PasLin67/Matrix_Led_Shield/4x4_Matrix_Led_Shield Eagle file/matrix_led_schield.brd

## EAGLE design 4x4_Matrix_Led_Shield Eagle file/matrix_led_schield.brd (2018-12-17)

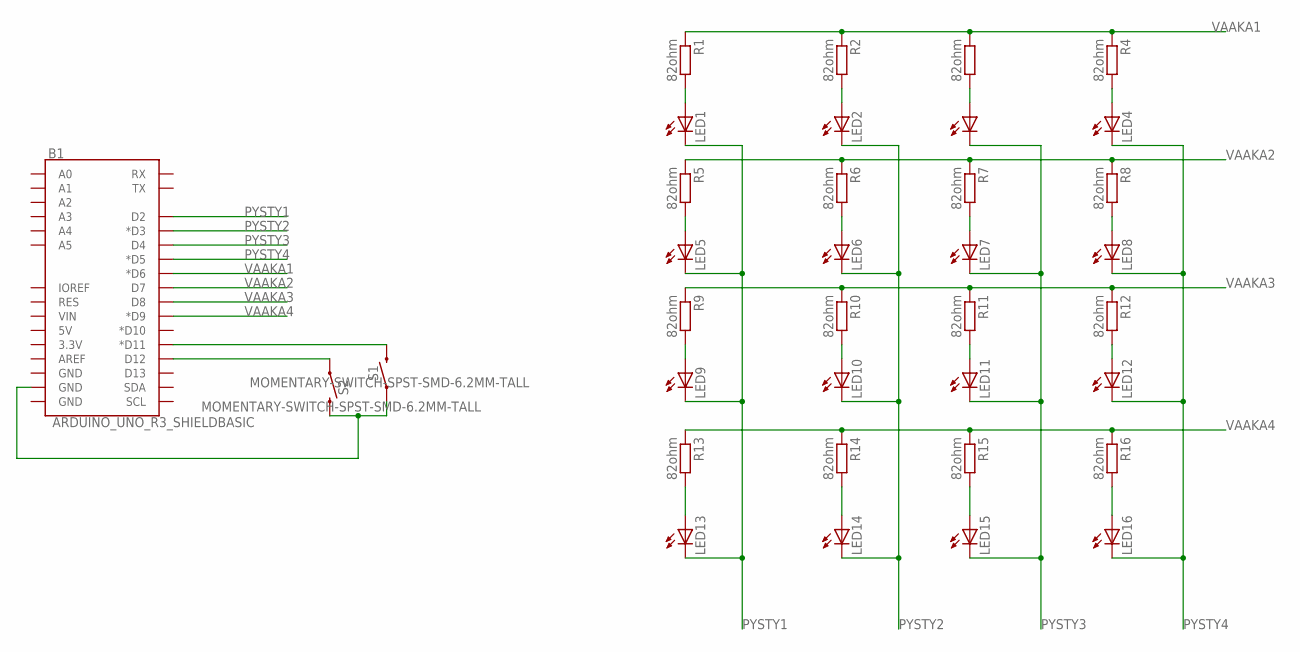
[picture p3: schematic matrix_led_shield_schematic.sch]

Parts:
B1: ARDUINO_UNO_R3_SHIELDBASIC; UNO_R3_SHIELD
LED1, LED2, LED3, LED4, LED5, LED6, LED7, LED8, LED9, LED10, LED11, LED12, LED13, LED14, LED15, LED16: LG_T679-E1F1-1; PLCC2
R1, R2, R3, R4, R5, R6, R7, R8, R9, R10, R11, R12, R13, R14, R15, R16: 82ohm; M0805
S1, S2: MOMENTARY-SWITCH-SPST-SMD-6.2MM-TALL; TACTILE_SWITCH_SMD_6.2MM_TALL

Connections:
unnamed: B1.D12, S2.A2 (1)
unnamed: B1.D11 (*D11), S1.B2 (2)
unnamed: B1.GND@1 (GND), S1.A2 (1), S2.B2 (2)
unnamed: LED1.A, R1.2
unnamed: LED2.A, R2.2
unnamed: LED3.A, R3.2
unnamed: LED4.A, R4.2
unnamed: LED5.A, R5.2
unnamed: LED6.A, R6.2
unnamed: LED7.A, R7.2
unnamed: LED8.A, R8.2
unnamed: LED9.A, R9.2
unnamed: LED10.A, R10.2
unnamed: LED11.A, R11.2
unnamed: LED12.A, R12.2
unnamed: LED13.A, R13.2
unnamed: LED14.A, R14.2
unnamed: LED15.A, R15.2
unnamed: LED16.A, R16.2
PYSTY1: B1.D2, LED1.C, LED5.C, LED9.C, LED13.C
PYSTY2: B1.D3 (*D3), LED2.C, LED6.C, LED10.C, LED14.C
PYSTY3: B1.D4, LED3.C, LED7.C, LED11.C, LED15.C
PYSTY4: B1.D5 (*D5), LED4.C, LED8.C, LED12.C, LED16.C
VAAKA1: B1.D6 (*D6), R1.1, R2.1, R3.1, R4.1
VAAKA2: B1.D7, R5.1, R6.1, R7.1, R8.1
VAAKA3: B1.D8, R9.1, R10.1, R11.1, R12.1
VAAKA4: B1.D9 (*D9), R13.1, R14.1, R15.1, R16.1

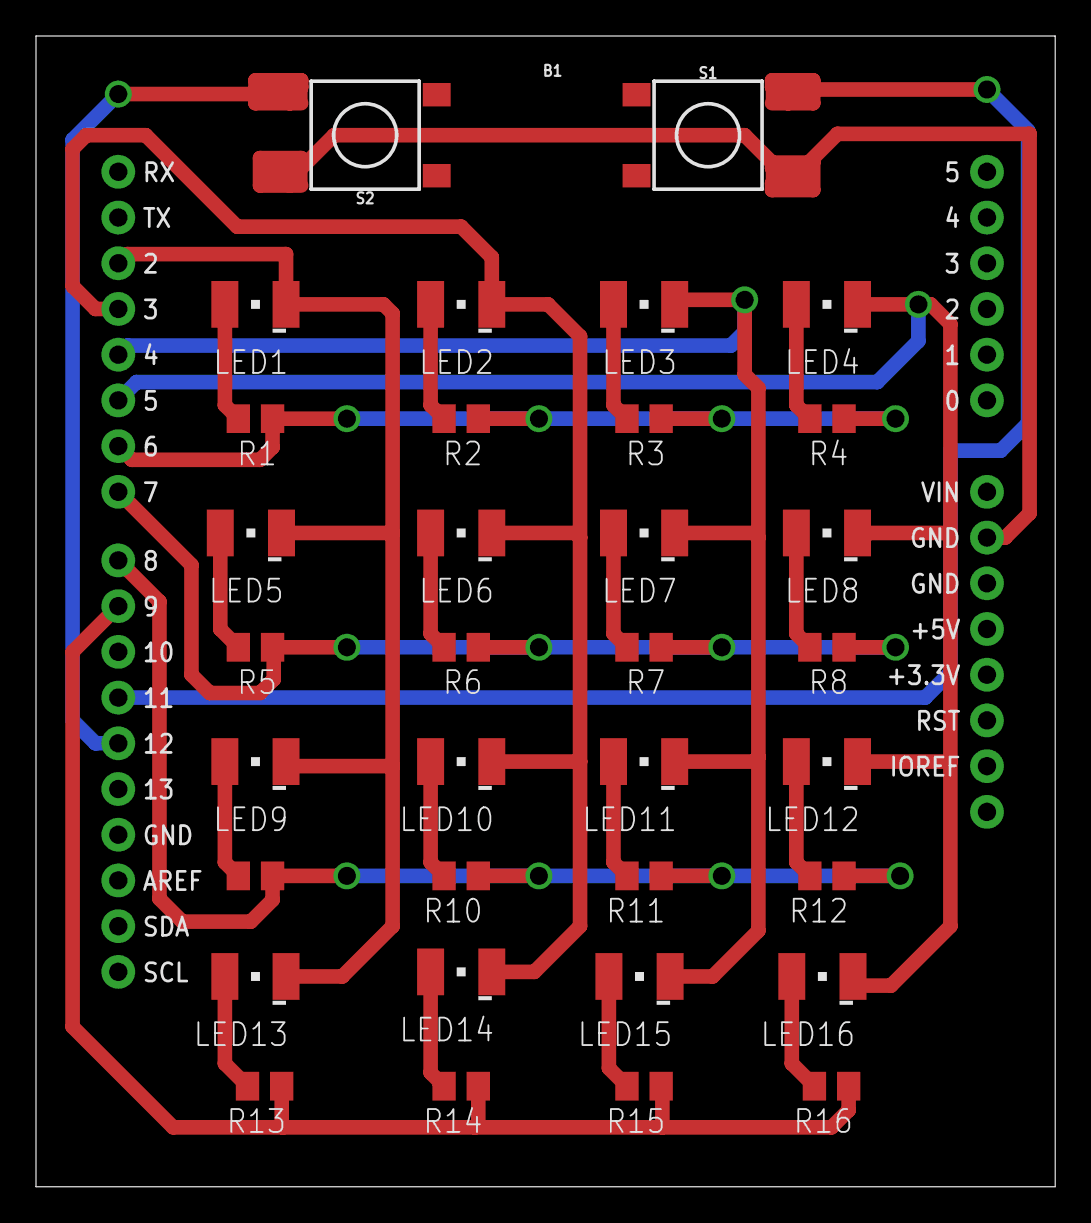
[picture p4: board matrix_led_schield.brd from above]

Board: 2 copper layers, 56.6 x 63.9 mm, 35 parts (0 on the bottom side), 27 nets.
